nejcKlanjscek/SummerCampOfInnovativeTechnologies/Firmware/README.md

Programska koda za poletni tabor inovativnih tehnologij PTIT2021
----------------------------------------------------------------

Programska koda je napisana v programskem jeziku C za mikrokrmilnik EFM8UB11F16G. 

Za razvoj smo uporabili [Silicon Labs Simplicity studio v5](https://www.silabs.com/developers/simplicity-studio) in vgrajen Keilov prevajalnik. Pod operacijskim sismemom Linux ta potrebuje okolje Wine. Samo razvojno okolje vas bo opozorilo, da si uredite brezplačno licenco za Keilov prevajalnik.

Za prenos programa na mikrokrmilnik, uporabimo Arduino Uno kot programator (pin 2, pin 3 in gnd). Sam načrt in programsko kodo za programator najdete [tukaj](https://github.com/conorpp/efm8-arduino-programmer).
