nejcKlanjscek/SummerCampOfInnovativeTechnologies/Dokumenti/Tabor inovativnih tehnologij 2021 BOM.xlsx

Summer school of inovative technologies
Status: | Designator: | Part: | Number of parts: | Description: | Price(1x): | Price(5x): | Price(10x): | Price(20x): | Price(50x): | Price(100x): | Price for 20 PCBs | Price for 15 PCBs | Farnell link:
 | C | 25PX100MEFC5X11 | 1 | 100uF Capacitor | / | 0.19 € | / | / | 0.09 € | / | 1.80 € | 1.35 € | https://si.farnell.com/rubycon/25px100mefc5x11/cap-100-f-25v-20/dp/2346578?st=100uf
 | C | B32520C3104K289 | 1 | 100nF Capacitor | / | / | 0.31 € | / | / | 0.24 € | 6.16 € | 4.62 € | https://si.farnell.com/epcos/b32520c3104k289/cap-0-1-f-250v-10-pet/dp/2797783?st=b32520
 | C | FG28X5R1E225KRT06 | 5 | 2.2uF Capacitor | / | 0.38 € | / | / | 0.20 € | / | 19.80 € | 14.85 € | https://si.farnell.com/tdk/fg28x5r1e225krt06/cap-2-2uf-25v-mlcc-radial/dp/3288106?st=2.2uf
 | C | RCER71H104K0M1H03A | 2 | 100nF Capacitor | / | 0.17 € | / | / | 0.20 € | / | 7.92 € | 5.94 € | https://si.farnell.com/murata/rcer71h104k0m1h03a/cap-0-1uf-50v-mlcc-radial/dp/2990750?ost=rcer71h104k0m1h03a
 | C | C1206C224K5RACTU | 1 | 220nF Capacitor | / | / | 0.12 € | / | / | / | 2.36 € | 1.77 € | https://si.farnell.com/kemet/c1206c224k5ractu/cap-0-22-f-50v-10-x7r-1206/dp/1414725?st=220nf
 | C | 12065C104JAT2A | 3 | 100nF Capacitor | / | / | 0.16 € | / | / | / | 9.72 € | 7.29 € | https://si.farnell.com/avx/12065c104jat2a/cap-0-1-f-50v-5-x7r-1206/dp/2280701?st=100nf
 | C | C3216X7R1E475K160AC | 2 | 4.2uF Capacitor | / | 0.23 € | / | / | / | / | 9.28 € | 6.96 € | https://si.farnell.com/tdk/c3216x7r1e475k160ac/cap-4-7-f-25v-10-x7r-1206/dp/1907356
 | C | MC0805N3R0C101A2.54MM | 1 | 3pF Capacitor | 0.31 € | / | 0.23 € | / | / | / | 4.68 € | 3.51 € | https://si.farnell.com/multicomp/mc0805n3r0c101a2-54mm/ceramic-capacitor-3pf-100v-c0g/dp/1694246
 | C | 63PX10MEFC5X11 | 3 | 10uF Capacitor | / | 0.25 € | / | / | / | / | 15.00 € | 11.25 € | https://si.farnell.com/rubycon/63px10mefc5x11/cap-10-f-63v-20/dp/2346610
 | C | RDEC71H475K2M1H03A | 1 | 10pF Capacitor | / | 0.77 € | / | / | / | / | 15.30 € | 11.47 € | https://si.farnell.com/murata/rdec71h475k2m1h03a/cap-4-7uf-50v-mlcc-radial/dp/2990793
 | CON | 42375-1856 | 1 | 3-pin pinheader | 0.15 € | / | 0.12 € | / | / | / | 2.42 € | 1.81 € | https://si.farnell.com/molex/42375-1856/connector-header-3pos-1row-2-54mm/dp/3049570?st=pinheader
 | D | BAT48 | 2 | Schotkey diode | 0.56 € | / | 0.36 € | / | / | / | 14.52 € | 10.89 € | https://si.farnell.com/stmicroelectronics/bat48/diode-schottky-small-signal/dp/9801472?st=bat48
 | D | 1N4007 SMD | 1 | Diode | / | 0.25 € | / | / | / | / | 4.92 € | 3.69 € | https://si.farnell.com/multicomp-pro/1n4007-smd/rectifier-1kv-1a-do-214ac/dp/3234222?st=1n4007
 | D | 1N4007RLG | 2 | Diode | 0.29 € | / | 0.28 € | / | / | / | 11.04 € | 8.28 € | https://si.farnell.com/on-semiconductor/1n4007rlg/diode-standard-1a-1kv-axial/dp/2317417?st=1n4007
 | D | BZX79C4V7 | 1 | Zenner diode | / | / | 0.14 € | / | / | / | 2.72 € | 2.04 € | https://si.farnell.com/on-semiconductor/bzx79c4v7/diode-zener-vz-4-7v/dp/1651557?st=zenner
 | IC | EFM8UB11F16G | 1 | 8-bit Microcontroler | 1.66 € | / | 1.39 € | / | / | / | / | / | https://si.farnell.com/silicon-labs/efm8ub11f16g-c-qsop24/mcu-8bit-50mhz-qsop-24/dp/2930499?st=efm8ub11f16g
 | IC | L7805ABD2T-TR | 1 | Voltage Regulator | 0.86 € | / | 0.69 € | / | / | / | 13.76 € | 10.32 € | https://si.farnell.com/stmicroelectronics/l7805abd2t-tr/ic-v-reg-5-0v-d2pak-3-7805/dp/1366571?st=l7805abd2t-tr
 | IC | LM324AN | 1 | OP Amplifier | / | / | 0.52 € | / | / | / | 10.48 € | 7.86 € | https://si.farnell.com/texas-instruments/lm324an/ic-op-amp-quad-12mhz/dp/3117049?st=lm324
 | IC | TL071IP | 1 | OP Amplifier | 0.71 € | / | 0.57 € | / | / | / | 11.40 € | 8.55 € | https://si.farnell.com/texas-instruments/tl071ip/ic-op-amp-jfet-pdip8/dp/3005120?st=tl071
 | J | 609-4049-1-ND | 1 | USB Connector | / | / | 0.60 € | / | 0.53 € | / | 12.10 € | 9.07 € | https://si.farnell.com/amphenol-icc-fci/10103593-0001lf/micro-usb-2-0-type-b-receptacle/dp/2293751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
 | LED | SSA-LXB10HW-GF/LP.. | 1 | LED Array | 2.38 € | / | 2.11 € | / | / | 1.40 € | 42.20 € | 31.65 € | https://si.farnell.com/lumex/ssa-lxb10hw-gf-lp/bar-graph-10-led-red-4mcd-105mw/dp/1020492?ost=ssa-lxb10hw-gf
 | MIC | ABM-712-RC | 1 | Microphone | 0.86 € | 1.03 | 0.95 € | 0.94 € | / | / | 19.04 € | 14.28 € | https://si.farnell.com/pro-signal/abm-712-rc/microphone-solder-pad/dp/1736569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
 | R | MCWR04X4700FTL | 10 | 470 Ω Resistor | / | / | / | / | / | 0.004 € | 0.74 € | 0.56 € | https://si.farnell.com/multicomp/mcwr04x4700ftl/res-470r-1-0-0625w-0402-thick/dp/2447178
 | R | MCRE000064 | 3 | 180k Ω Resistor | / | 0.02 € | / | / | 0.02 € | / | 1.48 € | 1.11 € | https://si.farnell.com/multicomp/mcre000064/res-180k-5-125mw-axial-carbon/dp/1700267?st=180k
 | R | MCHP06W2F1003T5E | 1 | 100kΩ Resistor | / | / | 0.07 € | / | / | / | 1.49 € | 1.12 € | https://si.farnell.com/multicomp/mchp06w2f1003t5e/res-100k-1-0-5w-1206-thick-film/dp/1576656
 | R | MCRE000061 | 2 | 100kΩ Resistor | / | 0.03 € | / | / | / | / | 1.07 € | 0.80 € | https://si.farnell.com/multicomp/mcre000061/res-100k-5-125mw-axial-carbon/dp/1700264
 | R | CRGH1206J1K0 | 1 | 1kΩ Resistor | / | / | 0.06 € | / | / | / | 1.22 € | 0.91 € | https://si.farnell.com/te-connectivity/crgh1206j1k0/res-1k-5-0-5w-1206-thick-film/dp/2331865#
 | R | MCRE000037 | 1 | 1kΩ Resistor | / | 0.03 € | / | / | / | / | 0.53 € | 0.40 € | https://si.farnell.com/multicomp/mcre000037/res-1k-5-125mw-axial-carbon-film/dp/1700237
 | R | MCRE000049 | 4 | 10kΩ Resistor | / | 0.03 € | / | / | / | / | 2.14 € | 1.60 € | https://si.farnell.com/w/c/passive-components/resistors-fixed-value/through-hole-resistors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
 | R | MCRE000045 | 2 | 4.7kΩ Resistor | / | 0.03 € | / | / | / | / | 1.07 € | 0.80 € | https://si.farnell.com/multicomp/mcre000045/res-4k7-5-125mw-axial-carbon-film/dp/1700245?st=4.7kohm
 | R | MCRE000081 | 1 | 4.7MΩ Resistor | / | 0.04 € | / | / | / | / | 0.72 € | 0.54 € | https://si.farnell.com/multicomp/mcre000081/res-4m7-5-125mw-axial-carbon-film/dp/1700286
 | R | MF12 30R | 1 | 30Ω Resistor | / | 0.04 € | / | / | / | / | 0.83 € | 0.62 € | https://si.farnell.com/multicomp/mf12-30r/res-30r-1-125mw-axial-metal-film/dp/9343024?st=30%20ohm
 | R | MF12 300R | 1 | 300Ω Resistor | / | 0.04 € | / | / | / | / | 0.84 € | 0.63 € | https://si.farnell.com/multicomp/mf12-300r/res-300r-1-125mw-axial-metal-film/dp/9342982?st=300%20ohm
 | R | VR25000002204JA500 | 1 | 2.2MΩ Resistor | / | / | 0.04 € | / | / | / | 0.79 € | 0.59 € | https://si.farnell.com/vishay/vr25000002204ja500/res-2m2-5-250mw-axial-metal-film/dp/2056502?st=2.2mohm
 | R | MP006982 | 1 | 2.4MΩ Resistor | / | / | 0.07 € | / | / | / | 1.48 € | 1.11 € | https://si.farnell.com/multicomp-pro/mp006982/res-2m4-0-25w-axial-metal-film/dp/3650161?st=2.4mohm
 | R | MCRE000057 | 2 | 47kΩ Resistor | / | 0.03 € | / | / | / | / | 1.07 € | 0.80 € | https://si.farnell.com/multicomp/mcre000057/res-47k-5-125mw-axial-carbon-film/dp/1700259
 | R | MCRE000065 | 4 | 220kΩ Resistor | / | 0.03 € | / | / | / | / | 2.14 € | 1.60 € | https://si.farnell.com/multicomp/mcre000065/res-220k-5-125mw-axial-carbon/dp/1700268
 | R | 3386P-1-204LF | 1 | 200kΩ Trimmer | / | / | 1.18 € | / | / | / | 23.60 € | 17.70 € | https://si.farnell.com/bourns/3386p-1-204lf/trimmer-200k/dp/9355090?ost=3386p
 | R | 3386F-1-205LF | 1 | 2M Trimmer | / | / | 1.17 € | / | / | / | 23.40 € | 17.55 € | https://si.farnell.com/bourns/3386f-1-205lf/trimmer-pot-2mohm-10-1turn-th/dp/2328524?ost=3386f
 | R | MCRE000073 | 1 | 1M Ressistor | / | 0.03 € | / | / | / | / | 0.53 € | 0.40 € | https://si.farnell.com/multicomp/mcre000073/res-1m-5-125mw-axial-carbon-film/dp/1700277
 | S | SWITCH | 1 | Pushbutton | / | / | / | / | / | / | / | /
 | U | LM358P | 2 | OP Amplifier | / | 0.49 € | 0.36 € | / | / | / | 14.32 € | 10.74 € | https://si.farnell.com/texas-instruments/lm358p/ic-op-amp-dual-dip8-358/dp/3117074?st=lm358
 |  | SUM:(75) | 75 |  |  |  |  | SUM: |  |  | 314.27 € | 235.70 €
 |  |  |  |  |  |  |  | MAX: |  |  | 260.00 €
