nejcKlanjscek/SummerCampOfInnovativeTechnologies/Dokumenti/Tabor inovativnih tehnologij 2021 Shema.pdf

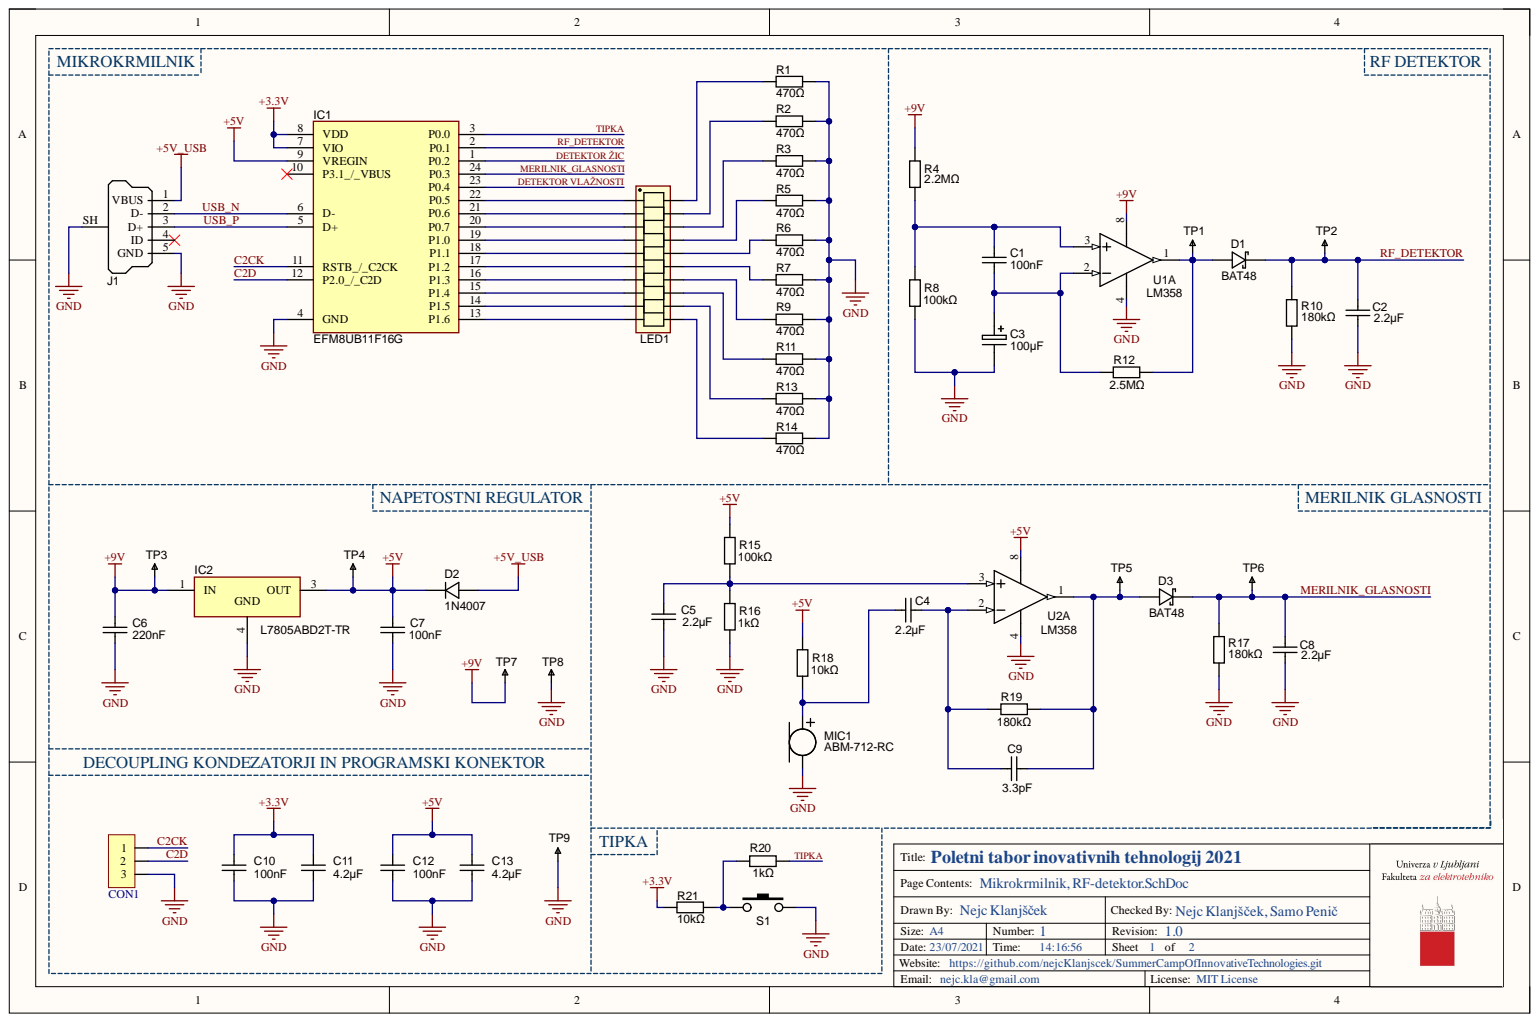
[picture p1: page 1]

DECOUPLING KONDEZATORJI IN PROGRAMSKI KONEKTOR

Poletni tabor inovativnih tehnologij 2021
Title:

Page Contents: Mikrokrmilnik, RF-detektor.SchDoc

Drawn By: Nejc Klanjšček | Checked By: Nejc Klanjšček, Samo Penič
Size: A4 | Number: 1 | Revision: 1.0
Date: 23/07/2021 | Time: 14:16:56 | Sheet 1 of 2

Website: https://github.com/nejcKlanjscek/SummerCampOfInnovativeTechnologies.git

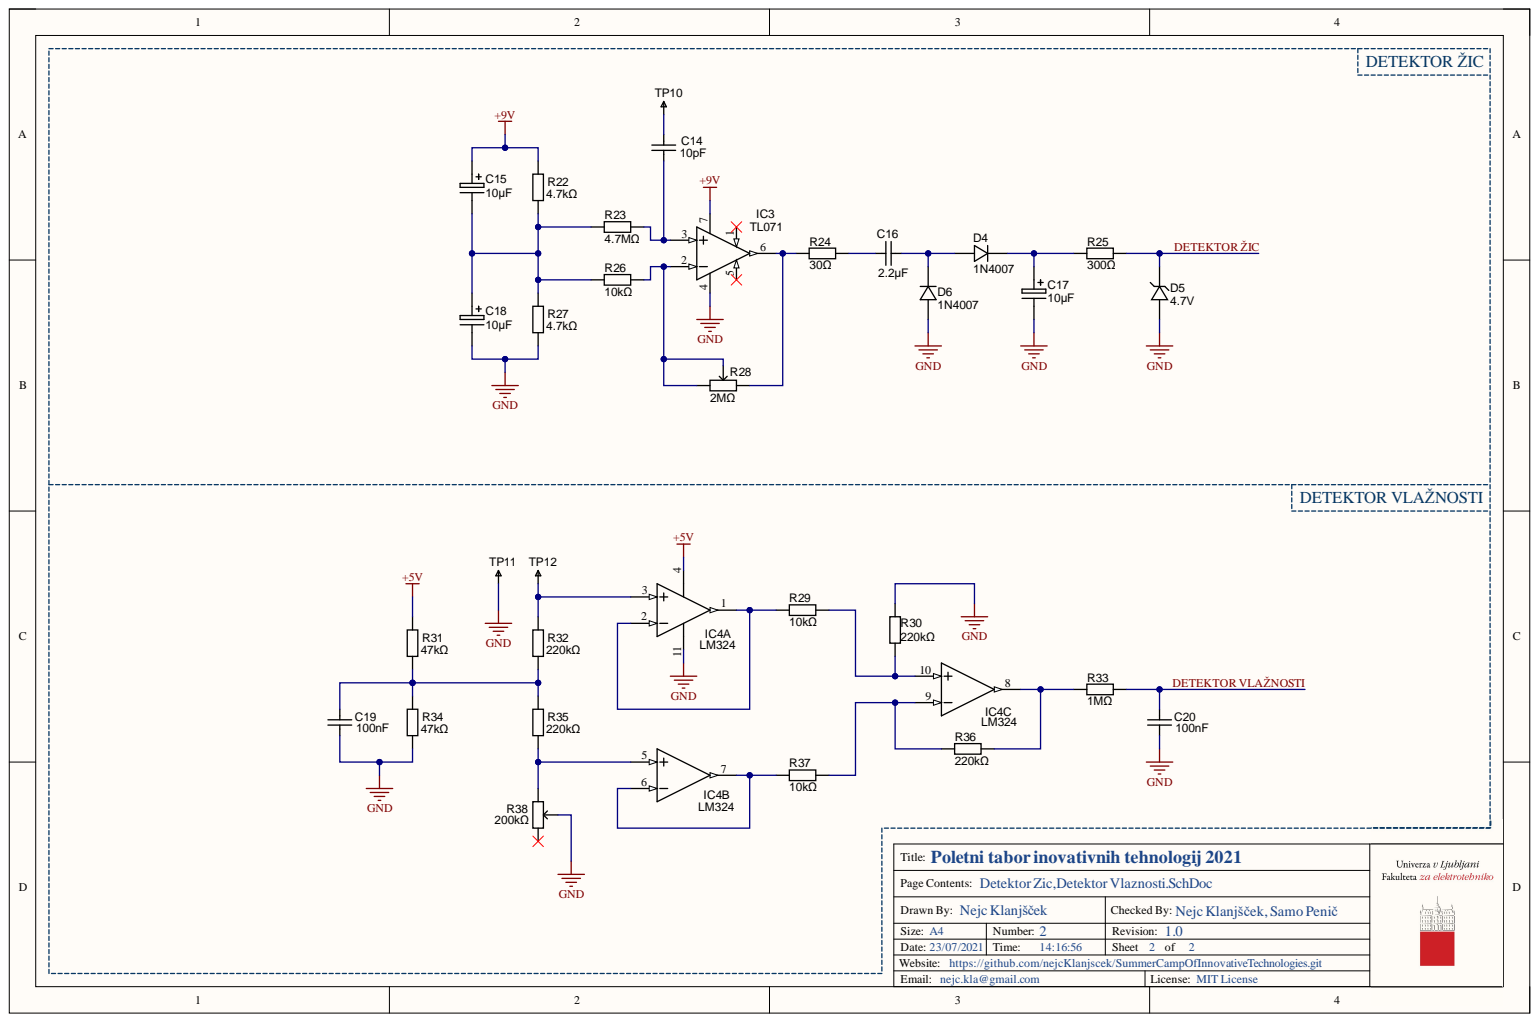
[picture p2: page 2]

Poletni tabor inovativnih tehnologij 2021
Title:

Page Contents: Detektor Zic,Detektor Vlaznosti.SchDoc

Drawn By: Nejc Klanjšček | Checked By: Nejc Klanjšček, Samo Penič
Size: A4 | Number: 2 | Revision: 1.0
Date: 23/07/2021 | Time: 14:16:56 | Sheet 2 of 2

Website: https://github.com/nejcKlanjscek/SummerCampOfInnovativeTechnologies.git
