nejcKlanjscek/SummerCampOfInnovativeTechnologies/Vezje/Tabor inovativnih tehnologij 2021.pdf

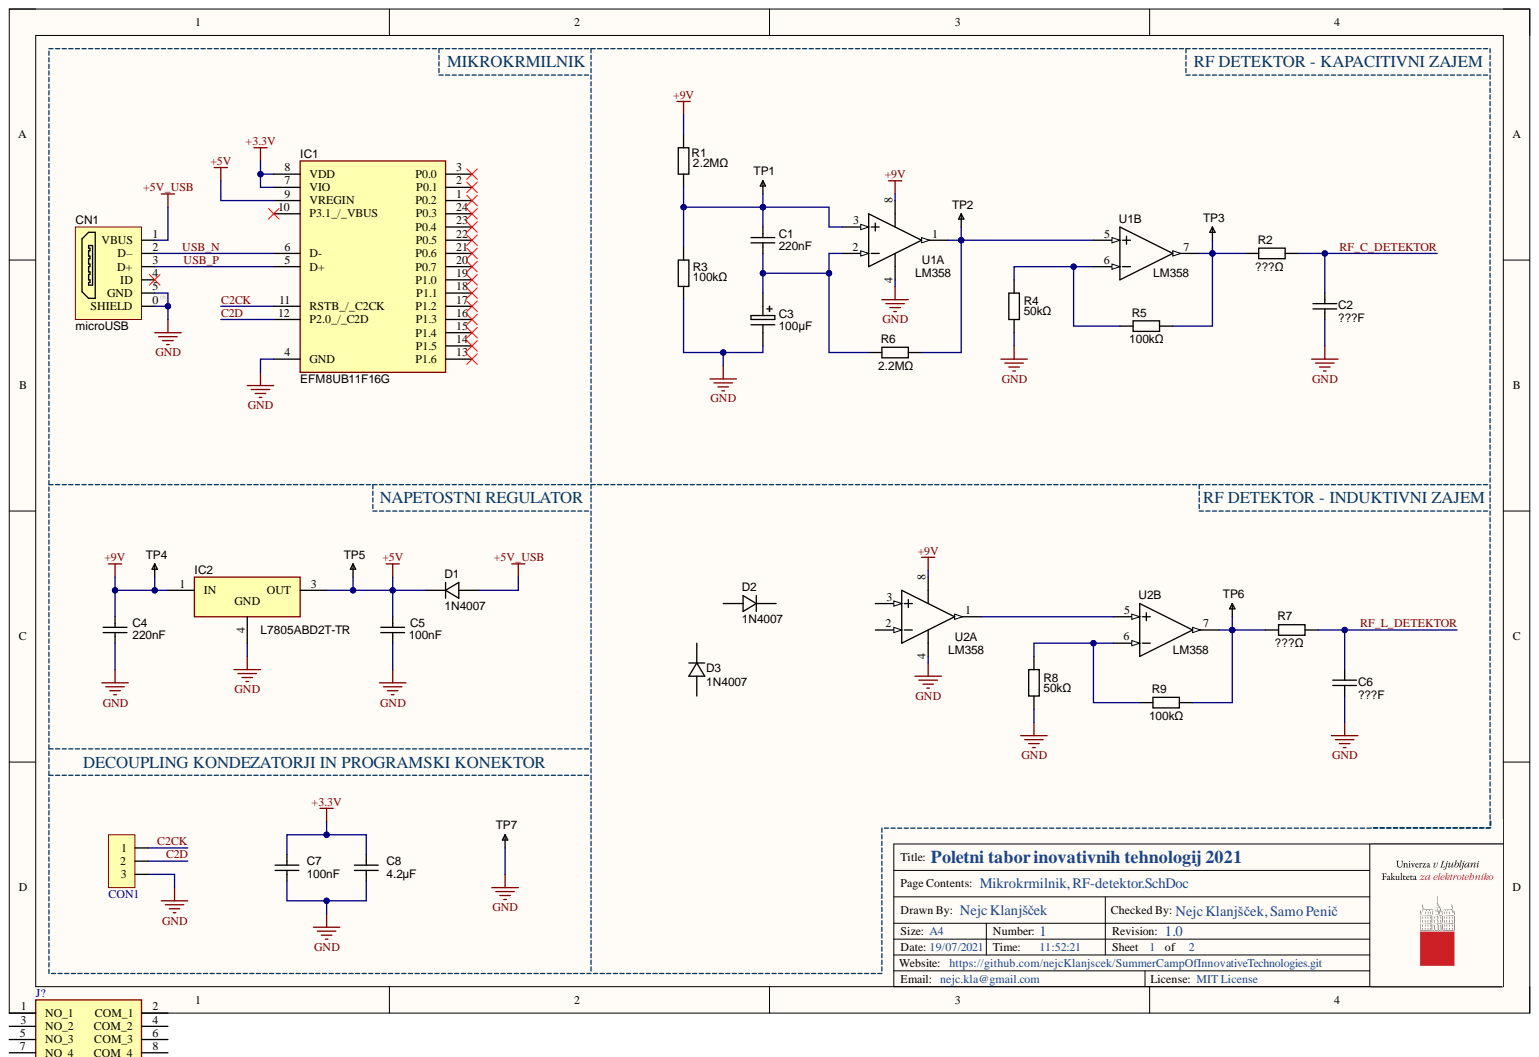
[picture p3: page 1]

RF DETEKTOR - KAPACITIVNI ZAJEM

RF DETEKTOR - INDUKTIVNI ZAJEM

DECOUPLING KONDEZATORJI IN PROGRAMSKI KONEKTOR

Poletni tabor inovativnih tehnologij 2021
Title:

Page Contents: Mikrokrmilnik, RF-detektor.SchDoc

Drawn By: Nejc Klanjšček | Checked By: Nejc Klanjšček, Samo Penič
Size: A4 | Number: 1 | Revision: 1.0
Date: 19/07/2021 | Time: 11:52:21 | Sheet 1 of 2

Website: https://github.com/nejcKlanjscek/SummerCampOfInnovativeTechnologies.git

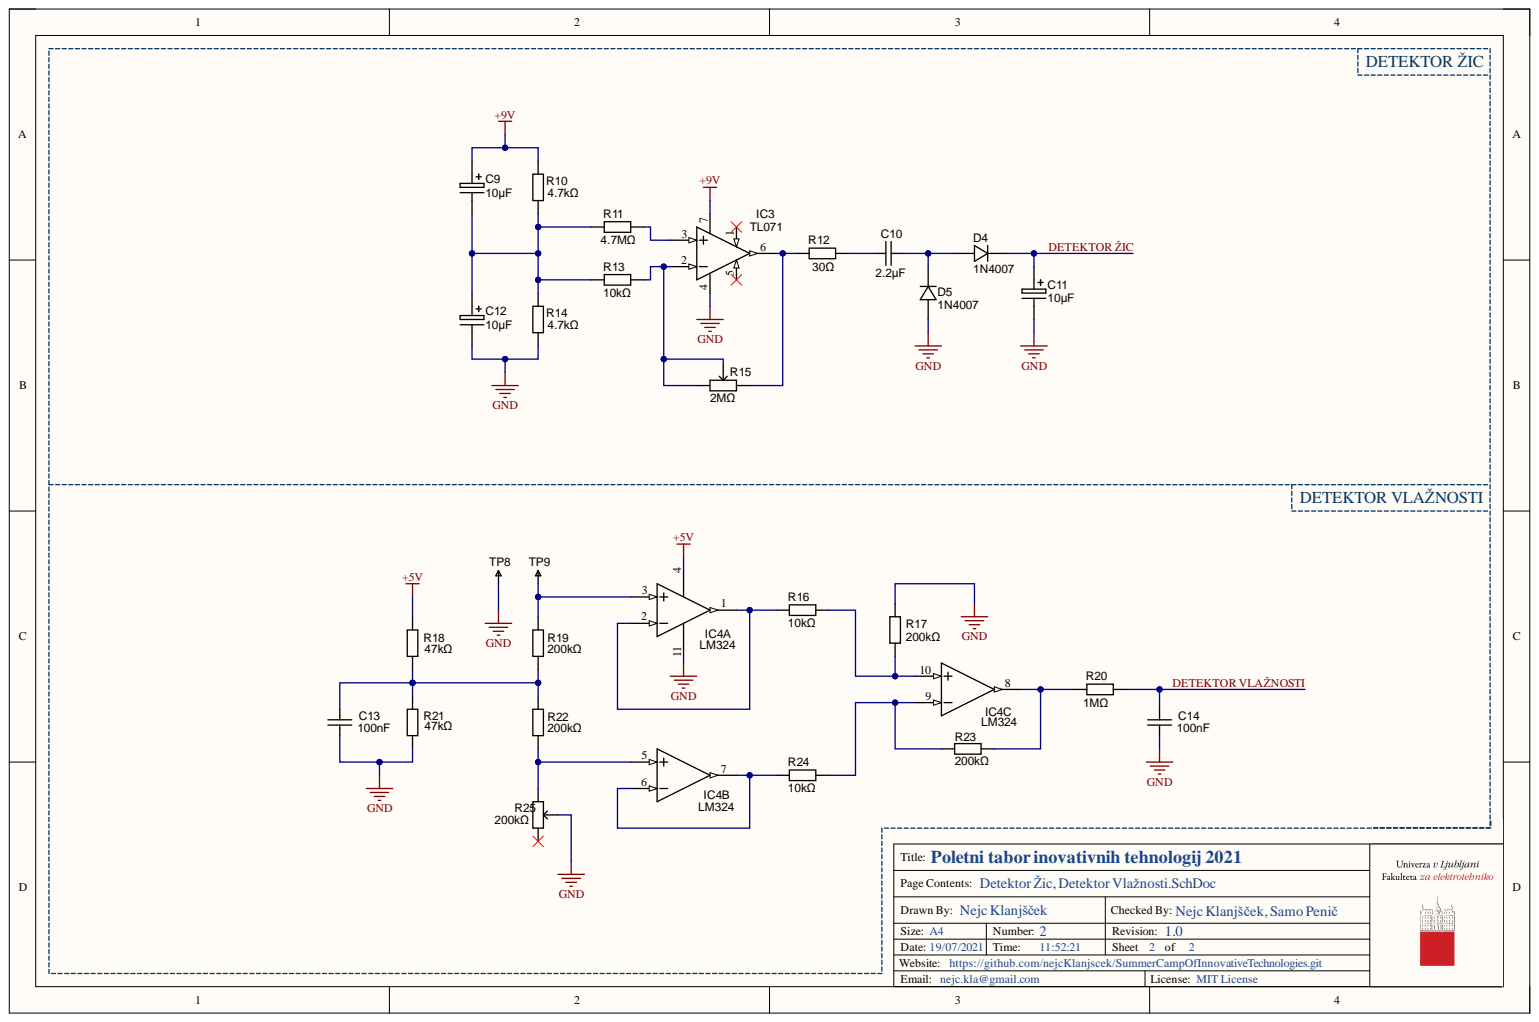
[picture p4: page 2]

Poletni tabor inovativnih tehnologij 2021
Title:
Page Contents: Detektor Žic, Detektor Vlažnosti.SchDoc

Drawn By: Nejc Klanjšček | Checked By: Nejc Klanjšček, Samo Penič
Size: A4 | Number: 2 | Revision: 1.0
Date: 19/07/2021 | Time: 11:52:21 | Sheet 2 of 2

Website: https://github.com/nejcKlanjscek/SummerCampOfInnovativeTechnologies.git
