nejcKlanjscek/SummerCampOfInnovativeTechnologies/(list of files, drawings)

Other design files:
Vezje/Detektor Zic,Detektor Vlaznosti.SchDoc
Vezje/Mikrokrmilnik, RF-detektor.SchDoc
Vezje/Tabor inovativnih tehnologij 2021.PrjPcb
