nejcKlanjscek/SummerCampOfInnovativeTechnologies/(threads)

Thread 2 (2021-08-18):

Connect P3.1/VBUS to USB VBUS

samop, 2021-08-18:
Make a connection between 5V pin at the USB connector  with VBUS sense pin on microcontroller.

This enables option to autodetect the type of power supply (battery vs. USB) in firmware.

Thread 5 (2021-08-18):

C3 is misplaced

samop, 2021-08-18:
C3 is not connected correctly. Do not place it onto the current version of the board (august 2021). Put it parallel to R8 (need some piggybacking).
