nejcKlanjscek/SummerCampOfInnovativeTechnologies/(commit log)

2021-07-23 1. iteration of PCB
    [BOM.xlsx, Detektor Zic,Detektor Vlaznosti.SchDoc, Mikrokrmilnik, RF-detektor.SchDoc, Tabor inovativnih tehnologij 2021.PrjPcb]
2021-07-23 Added BOM and Gerbers
    [BOM.xlsx, Detektor Zic,Detektor Vlaznosti.SchDoc, Mikrokrmilnik, RF-detektor.SchDoc, Tabor inovativnih tehnologij 2021 ALTIUM BOM.xls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]
2021-07-31 Updated BOM
    [BOM.xlsx, Mikrokrmilnik, RF-detektor.SchDoc, Tabor inovativnih tehnologij 2021.PrjPcb]
